ianm8/iDSB40/src/README.md

## Build
 *  Pi Pico
 *  CPU Speed: 240Mhz
 *  Optimize: -O3
 *  USB Stack: No USB
 *  Flash Size: 2MB (no FS)

## Some history
 * 1.0.240 iDSB, DSB
 * 2.1.240 CW, AM
 * 2.2.240 SSB - experimental
 * 3.1.240 Two-tone test
 * 3.2.240 SSB fixes
 * 3.3.240 CW gaussian
