ianm8/iDSB40/docs/WardenDSB.pdf

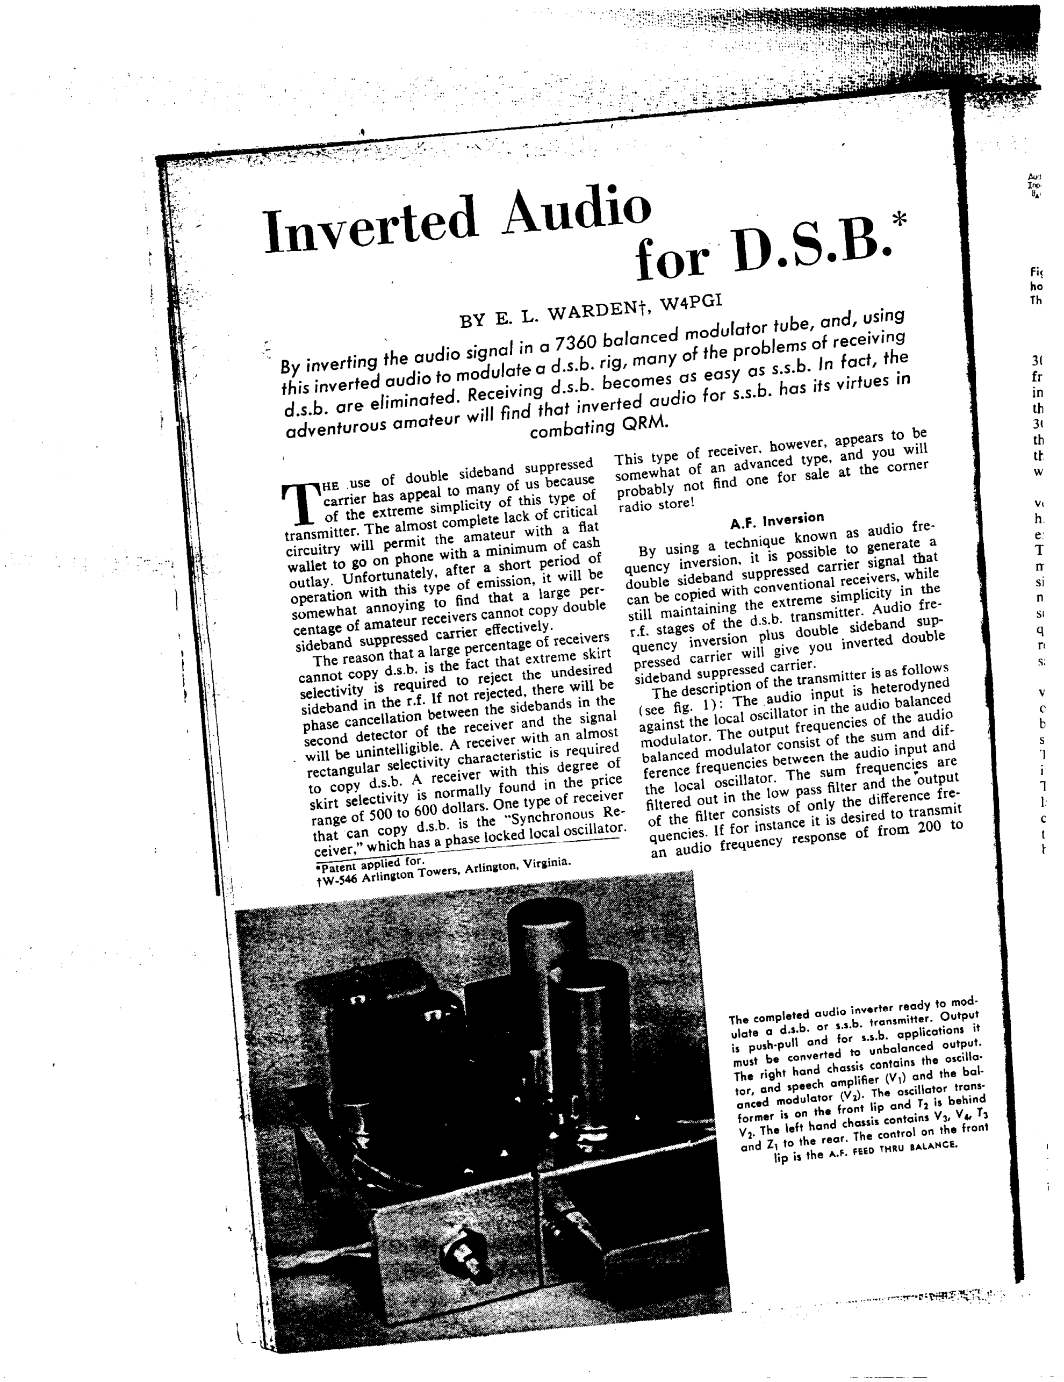
[picture p5: page 1]
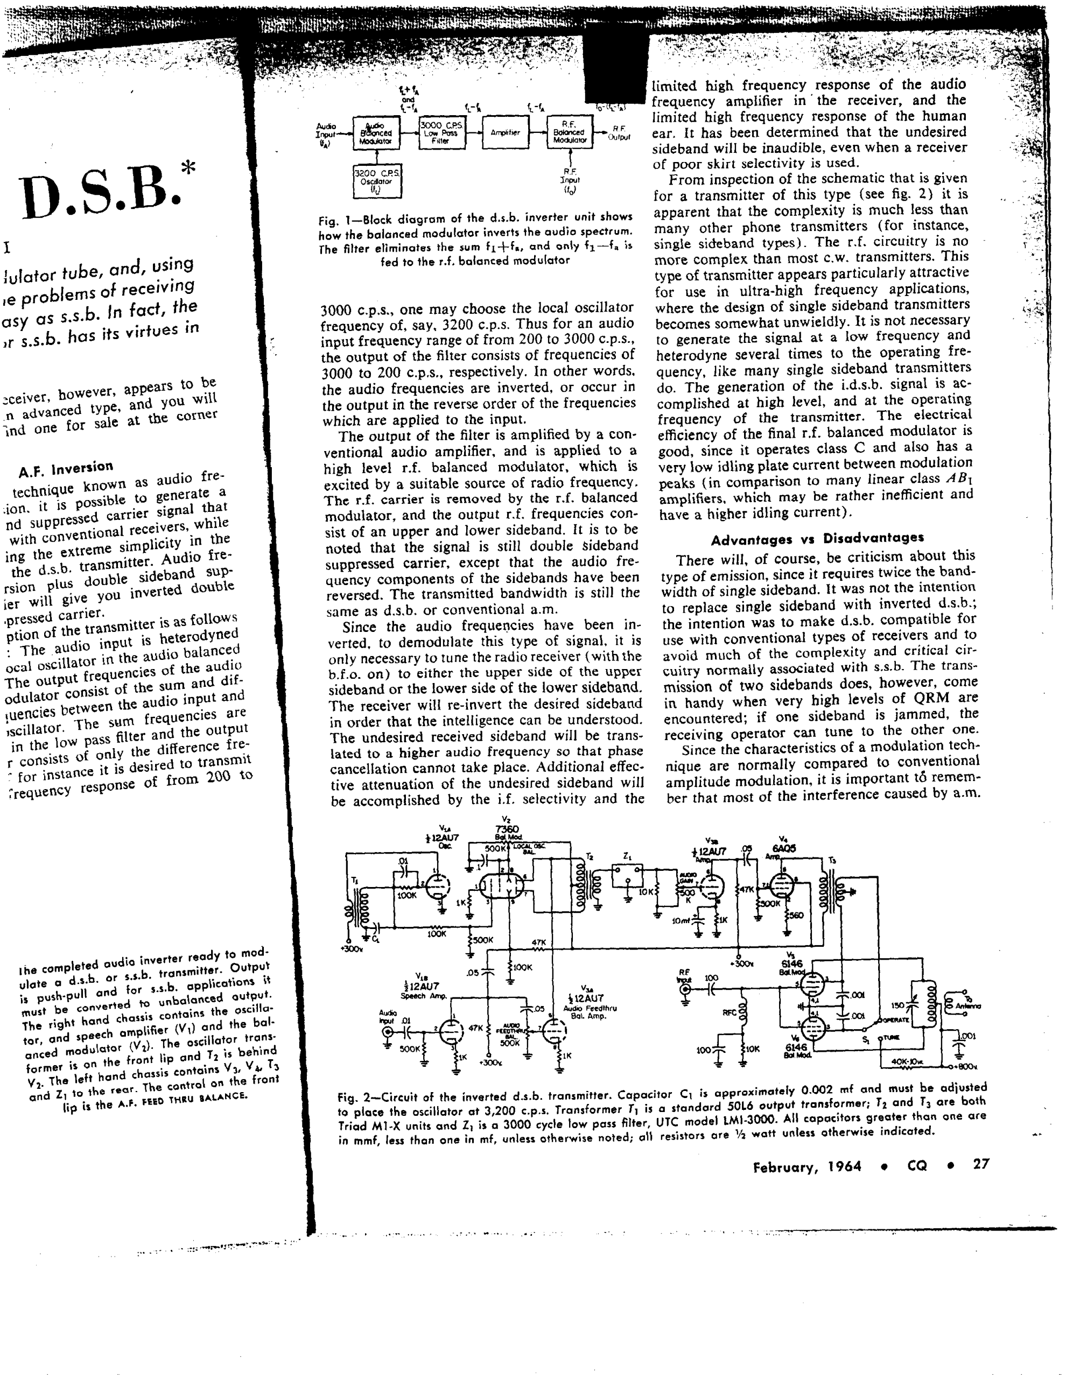
[picture p6: page 2]
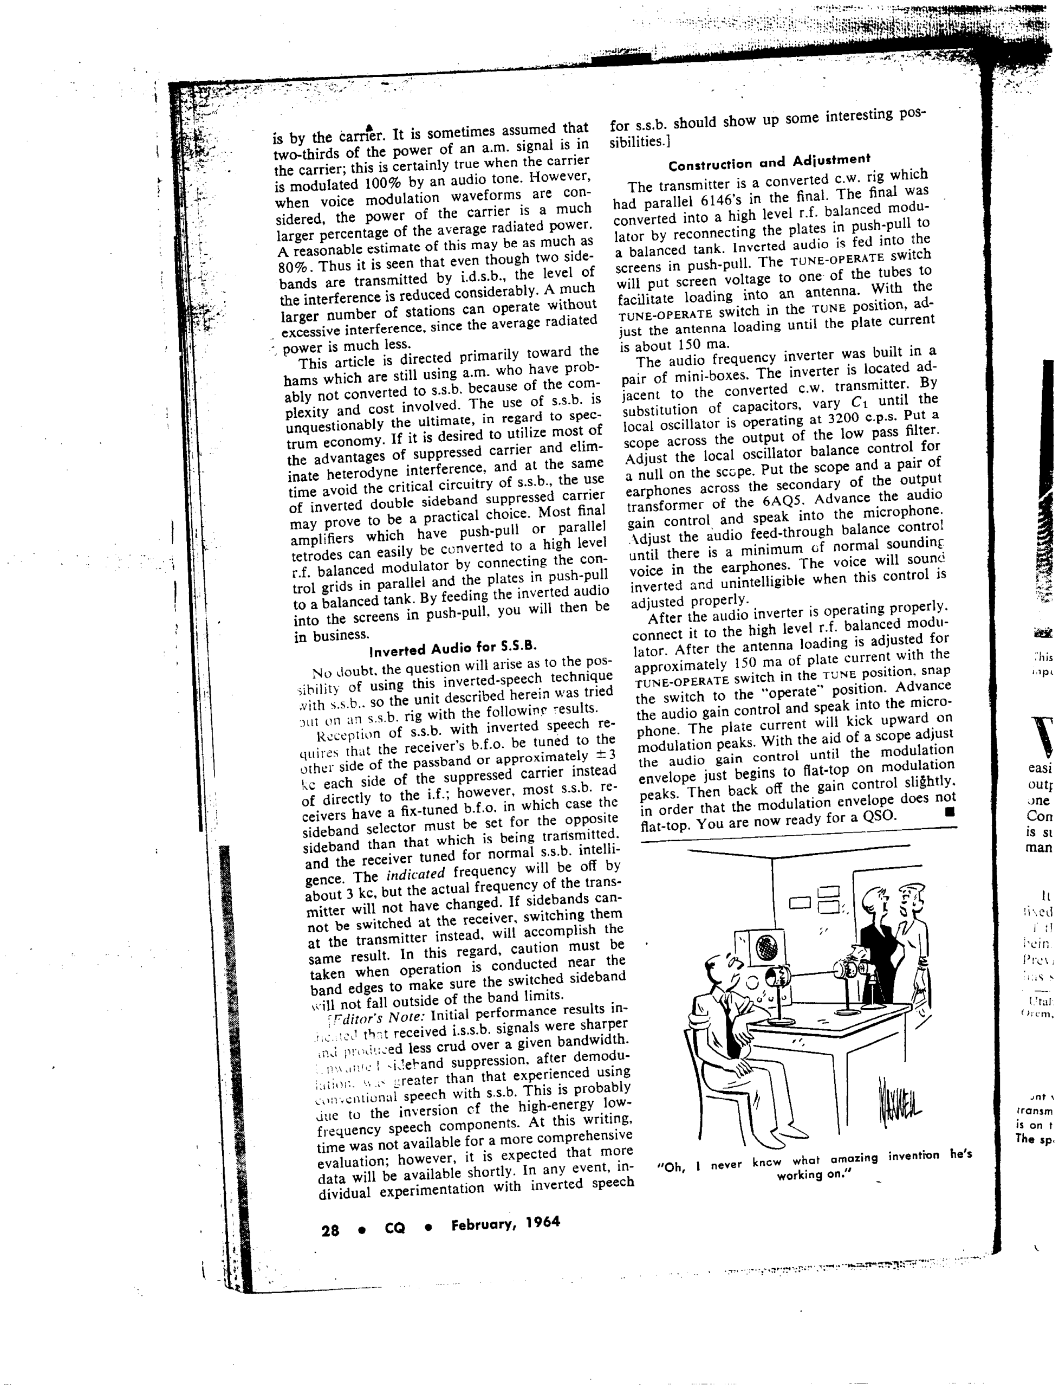
[picture p7: page 3]
