ianm8/iDSB40/src/V1/README.md

This version supports double sideband (DSB), inverse DSB (iDSB), CW and AM.

## To build in Arduino IDE

### Under Tools, set:
* Board: Raspberry Pi Pico
* CPU speed to 225MHz
* Optimize More (-O2)
* USB Stack: No USB
