ianm8/iDSB40/docs/Schematic_iDSB40_2024-08-17.pdf

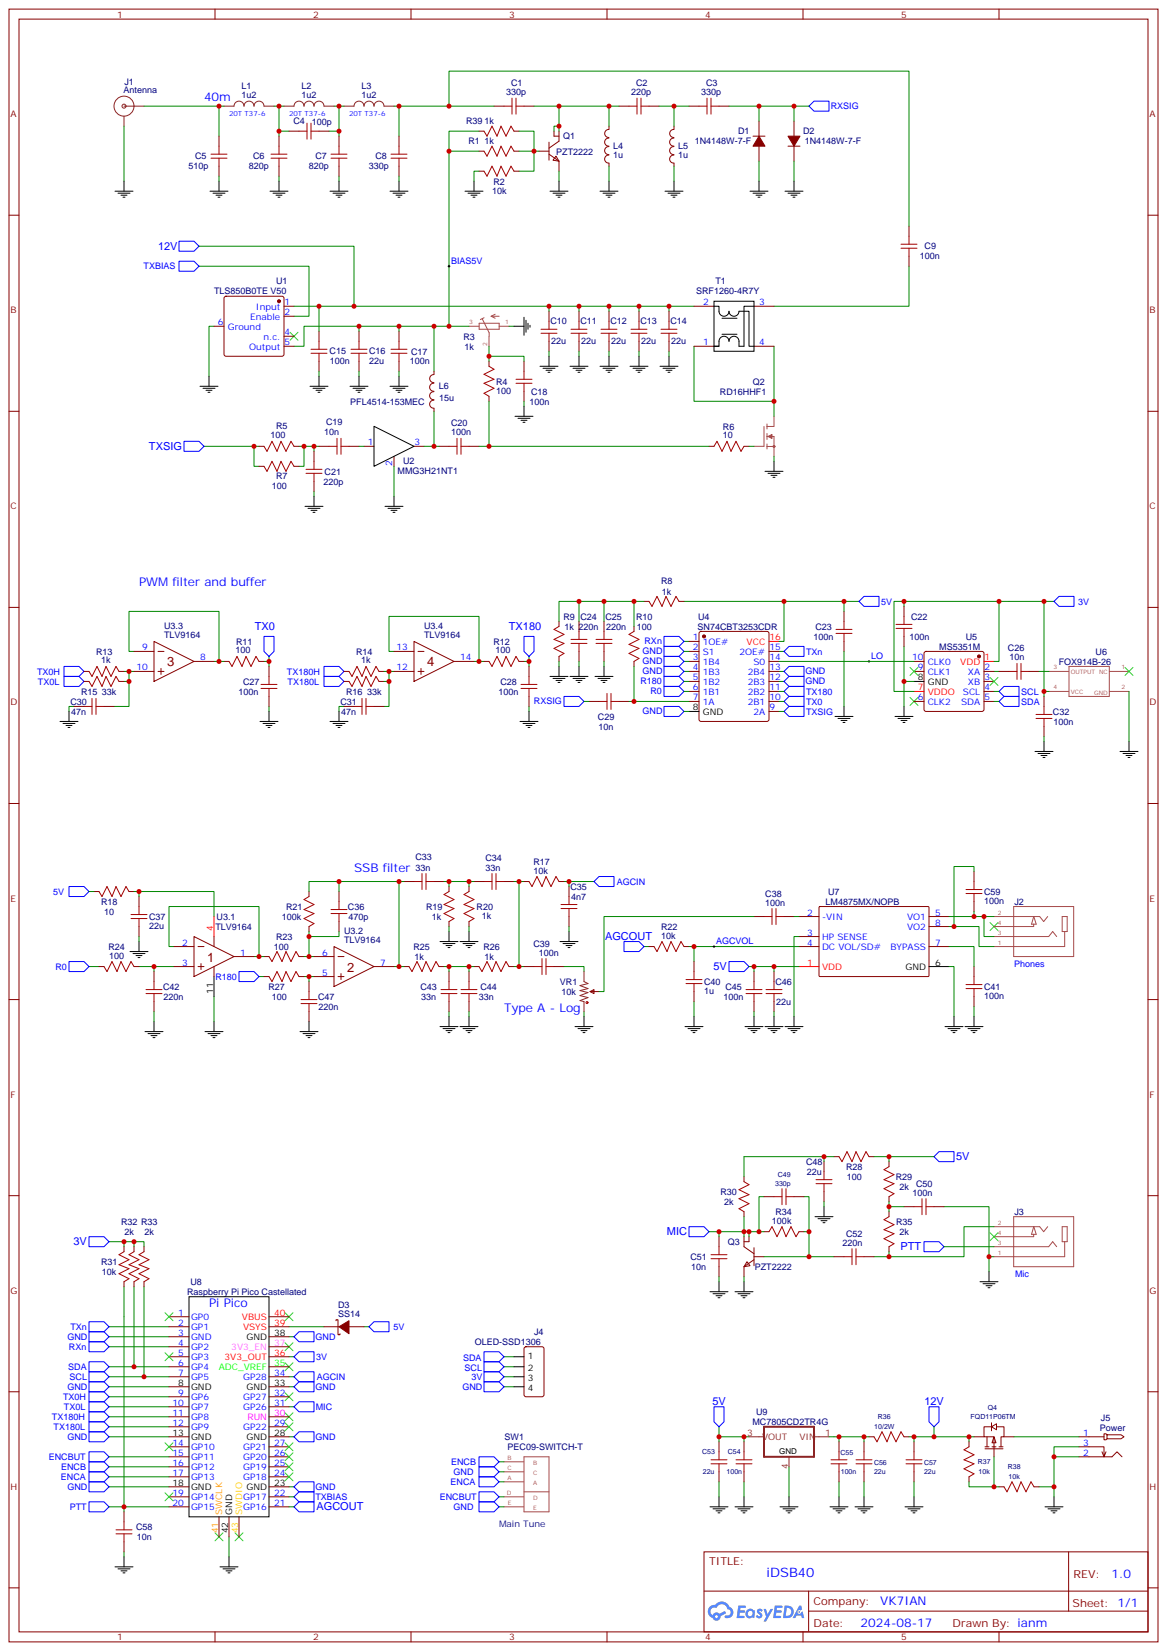
[picture p8: page 1]

PWM filter and buffer

Raspberry Pi Pico Castellated
