ianm8/iDSB40/src/dsp.h

/*
 * https://www.arc.id.au/FilterDesign.html
 */

#ifndef DSP_H
#define DSP_H

#define SAMPLERATE 31250
#define FIR_LENGTH 256
#define __mac_tap(_h) acc += (_h)*x[i++]

static const int16_t __not_in_flash("fast_access_sram") sin2700[] =
{
  32767,
  28056,
  15278,
  -1893,
  -18520,
  -29821,
  -32548,
  -25916,
  -11832,
  5654,
  21514,
  31189,
  31895,
  23430,
  8229,
  -9339,
  -24222,
  -32139,
  -30816,
  -20632,
  -4515,
  12900,
  26606,
  32661,
  29325,
  17557,
  741,
  -16288,
  -28634,
  -32747,
  -27443,
  -14249,
  3043,
  19459,
  30281,
  32395,
  25195,
  10750,
  -6786,
  -22370,
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
};
static const int32_t sin2700_size = sizeof(sin2700) / sizeof(int16_t);

static const int16_t __not_in_flash_func(lpf_2400)(const int16_t sample)
{
   // 31250 sample rate
   // 127 taps
   // 60dB
   static int32_t x[FIR_LENGTH] = { 0 };
   static uint8_t sample_index = 0;
   uint8_t i = sample_index;
   x[sample_index--] = sample;
   int32_t acc = 0;
   __mac_tap(-3);
   __mac_tap(-5);
   __mac_tap(-6);
   __mac_tap(-5);
   __mac_tap(-2);
   __mac_tap(2);
   __mac_tap(7);
   __mac_tap(12);
   __mac_tap(15);
   __mac_tap(14);
   __mac_tap(8);
   __mac_tap(-1);
   __mac_tap(-14);
   __mac_tap(-26);
   __mac_tap(-34);
   __mac_tap(-35);
   __mac_tap(-27);
   __mac_tap(-10);
   __mac_tap(14);
   __mac_tap(39);
   __mac_tap(59);
   __mac_tap(68);
   __mac_tap(60);
   __mac_tap(36);
   __mac_tap(-3);
   __mac_tap(-49);
   __mac_tap(-91);
   __mac_tap(-117);
   __mac_tap(-118);
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
  __mac_tap(0);
  __mac_tap(462);
  __mac_tap(0);
  __mac_tap(-2127);
  __mac_tap(0);
  __mac_tap(9896);
  __mac_tap(16384);
  __mac_tap(9896);
  __mac_tap(0);
  __mac_tap(-2127);
  __mac_tap(0);
  __mac_tap(462);
  __mac_tap(0);
  __mac_tap(-31);
  return (int16_t)(acc >> 15);
}

static const int16_t __not_in_flash_func(lpf_fs4_q)(const int16_t sample)
{
  // 31250
  // Taps: 15
  // Att: 60db
  static int32_t x[FIR_LENGTH] = { 0 };
  static uint8_t sample_index = 0;
  uint8_t i = sample_index;
  x[sample_index--] = sample;
  int32_t acc = 0;
  __mac_tap(-31);
  __mac_tap(0);
  __mac_tap(462);
  __mac_tap(0);
  __mac_tap(-2127);
  __mac_tap(0);
  __mac_tap(9896);
  __mac_tap(16384);
  __mac_tap(9896);
  __mac_tap(0);
  __mac_tap(-2127);
  __mac_tap(0);
  __mac_tap(462);
  __mac_tap(0);
  __mac_tap(-31);
  return (int16_t)(acc >> 15);
}

static const uint16_t __not_in_flash_func(atanj_fixed_31250)(uint16_t y, uint16_t x)
{
   // for sample rate of 31250
   static const uint16_t __not_in_flash("fast_access_sram") A_fixed[65] = {
      0,
      0,
      0,
      1,
      1,
      2,
      3,
      5,
      8,
      11,
      14,
      19,
      24,
      30,
      36,
      44,
      53,
      62,
      73,
      84,
      97,
      111,
      125,
      141,
      158,
      176,
      194,
      214,
      235,
      257,
      280,
      304,
      329,
      355,
      382,
      409,
      437,
      467,
      497,
      527,
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
   };

   static const uint16_t __not_in_flash("fast_access_sram") B_fixed[65] = {
      4973,
      4971,
      4966,
      4959,
      4949,
      4937,
      4923,
      4906,
      4887,
      4866,
      4843,
      4818,
      4791,
      4762,
      4731,
      4698,
      4664,
      4628,
      4590,
      4551,
      4511,
      4469,
      4426,
      4383,
      4338,
      4292,
      4246,
      4198,
      4151,
      4102,
      4053,
      4004,
      3954,
      3904,
      3854,
      3803,
      3753,
      3702,
      3652,
      3602,
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
   };

   if (x == 0) return 0;
   const uint32_t value = (y << 16) / x;
   const uint8_t index = (uint8_t)(value >> 10);
   return A_fixed[index] + ((B_fixed[index] * value) >> 16);
}

#define PI__OVER_TWO (SAMPLERATE/4)
#define ONE__PI (SAMPLERATE/2)
#define TWO__PI (SAMPLERATE)

const int16_t __not_in_flash_func(atan2j)(int16_t y, int16_t x)
{
   int16_t z = 0; // returned value
   bool x_is_negative = false;
   bool y_is_negative = false;
   if (x < 0)
   {
      x_is_negative = true;
      x = -x;
   }
   if (y < 0)
   {
      y_is_negative = true;
      y = -y;
   }

   if (y < x)
   {
      z = atanj_fixed_31250(y, x);
   }
   else
   {
      z = atanj_fixed_31250(x, y);
      z = PI__OVER_TWO - z;
   }
   if (x_is_negative) z = ONE__PI - z;
   if (y_is_negative) z = TWO__PI - z;
   /***********************
    * the above statement ensures that the returned value is between 0 and 2*pi
    * If one wants the returned value to be between -pi and +pi, replace that
    * statement with;
    *
    * 		z = -z;
    *
    * *************************/

   return z;
}

#define iter1(N) \
  partial = root + (1 << (N)); \
  if (n >= partial << (N)) \
  { \
    n -= partial << (N); \
    root |= 2 << (N); \
  }

static const uint32_t __not_in_flash_func(isqrt)(uint32_t n)
{
  uint32_t root = 0;
  uint32_t partial = 0;
  iter1(15);
  iter1(14);
  iter1(13);
  iter1(12);
  iter1(11);
  iter1(10);
  iter1(9);
  iter1(8);
  iter1(7);
  iter1(6);
  iter1(5);
  iter1(4);
  iter1(3);
  iter1(2);
  iter1(1);
  iter1(0);
  return root >> 1;
}

static const int16_t __not_in_flash_func(dc)(const int16_t in)
{
  static int32_t s = 0;
  static int32_t x1 = 0;
  static int16_t y1 = 0;
  s -= x1;
  x1 = (int32_t)in << 16;
  s += x1 - ((int32_t)y1 << 10);
  return (y1 = s >> 16);
}

static const int16_t __not_in_flash_func(process_iDSB)(const int16_t s)
{
  // for iDSB, LPF, Mix, LPF, ALC
  // used to keep maximum level to 10 bits
  // so that PWM does not overflow
  volatile static int32_t alc = 256L;

  // remove DC and band limit mic signal
  const int32_t mic = lpf_2400(hpf_300(s));

  static uint32_t lo = 0;
  const int32_t bfo = sin2700[lo];
  lo++;
  if (lo>=sin2700_size)
  {
    lo = 0;
  }

  // note extra divide by 2 to bring
  // value close to 10 bit range for PWM
  const int16_t mixer_out = (int16_t)((bfo * mic) >> 16);

  // remove the image
  const int32_t mic_out = ((int32_t)lpf_2500(mixer_out) * alc) >> 8;

  // ALC
  if (abs(mic_out)>511L) alc--;
  return mic_out;
}

static const int16_t __not_in_flash_func(process_DSB)(const int16_t s)
{
  // used to keep maximum level to 10 bits
  // so that PWM does not overflow
  volatile static int32_t alc = 256L;

  // remove DC and band limit mic signal
  const int32_t mic_in = lpf_2400(hpf_300(s));
  //const int32_t mic_in = lpf_2400(dc(s));
  const int32_t mic_out = (mic_in * alc) >> (8 + 2);

  // ALC
  if (abs(mic_out)>511L) alc--;
  return mic_out;
}

static const int16_t __not_in_flash_func(process_AM)(const int16_t s)
{
  // remove DC and band limit mic signal
  const int32_t mic_in = lpf_2400(dc(s));

  // reduce mic input to 7 bits (+/-64)
  // so that adding 64 gives max 100% modulation
  const int16_t mic_out = (mic_in>>5) + 64;
  return mic_out;
}

// envelope delay taps 32us each
// sweep 0..5 on air
#define ENV_DELAY_TAPS 1

static const int16_t __not_in_flash_func(process_SSB)(const int16_t s,int16_t &frequency,const uint8_t env_delay = ENV_DELAY_TAPS)
{
  volatile static int32_t alc = 256L;
  volatile static int16_t prev_phase = 0;
  volatile static uint8_t lo = 0;
  const uint8_t bfo = lo & 0x03;

  // bfo oscillates
  lo++;

  // remove DC and band limit mic signal
  const int16_t mic_in = lpf_SSB_2400(hpf_300(s));

  // up convert to FS/4
  int16_t v = 0;
  switch (bfo)
  {
    case 0: v = +mic_in; break;
    case 2: v = -mic_in; break;
  }

  // remove the upper image
  v = lpf_fs4(v);

  // down convert into quadrature
  int16_t sig_i = 0;
  int16_t sig_q = 0;
  switch (bfo)
  {
    case 0: sig_i = +v; break;
    case 1: sig_q = +v; break;
    case 2: sig_i = -v; break;
    case 3: sig_q = -v; break;
  }

  // remove the upper image with another FS/4 LPF
  sig_i = lpf_fs4_i(sig_i);
  sig_q = lpf_fs4_q(sig_q);

  // get the phase
  const int16_t phase = atan2j(sig_q, sig_i);

  // get the frequency
  int16_t freq = phase - prev_phase;
  prev_phase = phase;

  // wrap to [-fs/2, +fs/2) and
  // allow for 180 degree postive and
  // negative phase shifts at zero
  // envelope amplitude
  if (freq >= ONE__PI) freq -= TWO__PI;
  else if (freq < -ONE__PI) freq += TWO__PI;
  frequency = constrain(freq, -8000, 8000);;

  // get magnitude
  int32_t magnitude = isqrt((int32_t)sig_i*sig_i + (int32_t)sig_q*sig_q);

  // envelope delay: 1 tap = 32us
  static int16_t mag_dly[16] = {0};
  static uint8_t mp = 0;
  mag_dly[mp & 15] = magnitude;
  magnitude = mag_dly[(uint8_t)(mp - env_delay) & 15];
  mp++;

  // ALC
  magnitude = (magnitude * alc) >> 8;
  if (magnitude>1023) alc--;

  return magnitude;
}

#endif
