ianm8/iDSB40/src/CW.h

#ifndef CW_H
#define CW_H

#define CW_LEVEL (int16_t)511

static const uint16_t __not_in_flash("fast_access_sram") gaussian_tab[312] =
{
  32767,
  32765,
  32759,
  32748,
  32733,
  32714,
  32691,
  32664,
  32633,
  32597,
  32557,
  32513,
  32465,
  32413,
  32357,
  32297,
  32233,
  32165,
  32092,
  32016,
  31936,
  31852,
  31764,
  31673,
  31577,
  31478,
  31375,
  31269,
  31158,
  31045,
  30927,
  30806,
  30682,
  30554,
  30423,
  30289,
  30151,
  30010,
  29866,
  29718,
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
};

static const int16_t __not_in_flash_func(process_CW)(const bool keydown)
{
  static constexpr int32_t max_sig = CW_LEVEL;
  volatile static uint32_t gaussian_phase = 0;
  volatile static enum cw_state_t
  {
    CW_STATE_KEYUP,
    CW_STATE_KEYDOWN,
    CW_STATE_KEY_TRANSITION_TO_DOWN,
    CW_STATE_KEY_TRANSITION_TO_UP
  }
  cw_state = CW_STATE_KEYUP;
  int16_t cw_out = 0;
  switch (cw_state)
  {
    case CW_STATE_KEYUP:
    {
      cw_out = 0;
      // if keydown then transition to key down
      if (keydown)
      {
        gaussian_phase = 311;
        cw_state = CW_STATE_KEY_TRANSITION_TO_DOWN;
      }
      break;
    }
    case CW_STATE_KEY_TRANSITION_TO_DOWN:
    {
      // stay here until gaussian done
      const int32_t gaussian = gaussian_tab[gaussian_phase];
      cw_out = (max_sig * gaussian) >> 15;
      gaussian_phase--;
      if (gaussian_phase==0)
      {
        cw_state = CW_STATE_KEYDOWN;
      }
      break;
    }
    case CW_STATE_KEYDOWN:
    {
      // stay here while key down
      cw_out = max_sig;
      if (keydown)
      {
        break;
      }
      gaussian_phase = 0;
      cw_state = CW_STATE_KEY_TRANSITION_TO_UP;
      break;
    }
    case CW_STATE_KEY_TRANSITION_TO_UP:
    {
      // stay here until gaussian done
      const int32_t gaussian = gaussian_tab[gaussian_phase];
      cw_out = (max_sig * gaussian) >> 15;
      gaussian_phase++;
      if (gaussian_phase>=312)
      {
        cw_state = CW_STATE_KEYUP;
      }
      break;
    }
  }
  return cw_out;
}

#endif
