ianm8/iDSB40/(commit log)

2024-09-01 PCB bottom showing Pico
2024-09-01 PCB underside showing Pico
2024-09-10 Bug fix - update frequency when mode changes.
    [iDSB40.ino]
2026-07-12 Version 3.3.240
    SSB fixes
    [CW.h, Rotary.cpp, Rotary.h, agc.h, dsp.h, iDSB40.ino, si5351mcu.cpp, si5351mcu.h]
